PACT-Precision-Ag-Climate-Telemetry/mainboard-master/PACT_Mainboard_RevA/gerber/drill_report.txt

Drill report for mainboard-master.kicad_pcb
Created on 2026-10-30T01:10:53

Copper Layer Stackup:
    =============================================================
    L1 :  F.Cu                      front
    L2 :  B.Cu                      back

Drill file 'mainboard-master-PTH.drl' contains
    plated through holes:
    =============================================================
    T1  0.400mm  0.0157"  (92 holes))
    T2  0.750mm  0.0295"  (4 holes))
    T3  0.800mm  0.0315"  (73 holes))
    T4  0.950mm  0.0374"  (29 holes))
    T5  1.000mm  0.0394"  (24 holes))

    Total plated holes count 222

Drill file 'mainboard-master-NPTH.drl' contains
    unplated through holes:
    =============================================================
    T1  3.200mm  0.1260"  (13 holes))

    Total unplated holes count 13
