PACT-Precision-Ag-Climate-Telemetry/mainboard-master/IoTeKMITL-C1bplApo.png

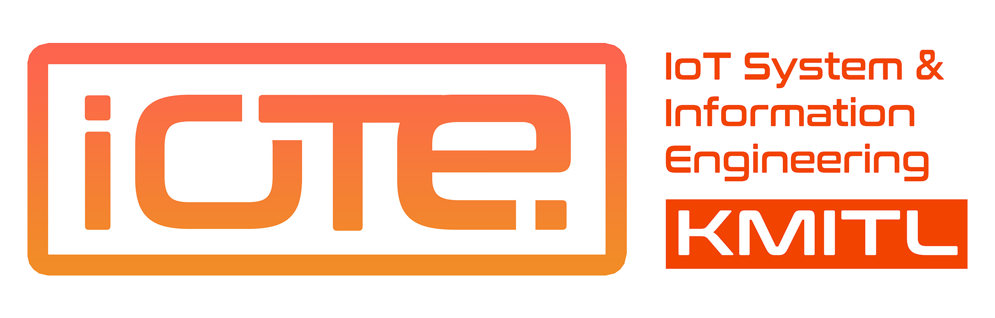
IoTeKMITL-C1bplApo.png
