PACT-Precision-Ag-Climate-Telemetry/mainboard-master/PACT_Mainboard_RevA/render_bottom.png

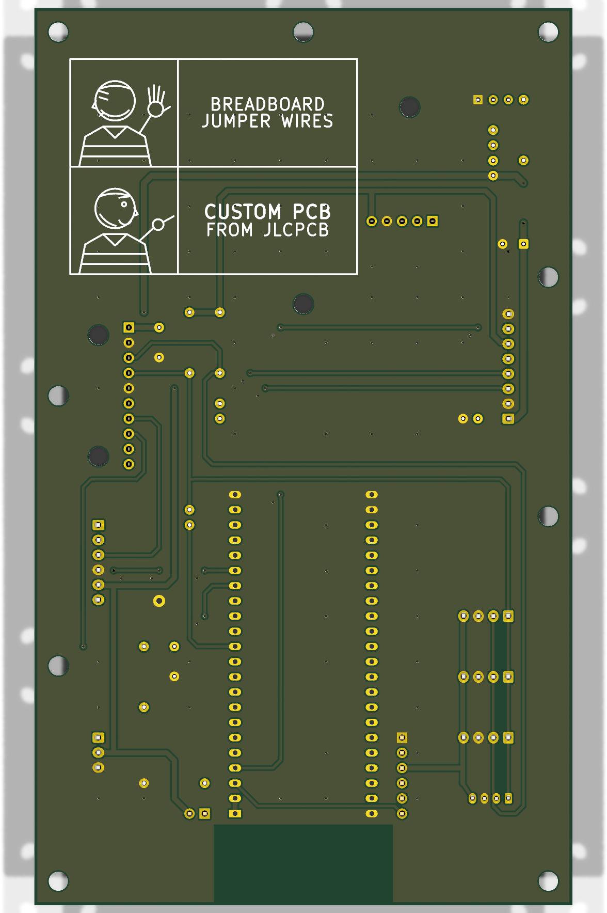
PACT_Mainboard_RevA/render_bottom.png
