PACT-Precision-Ag-Climate-Telemetry/mainboard-master/PACT_Mainboard_RevA/render_top.png

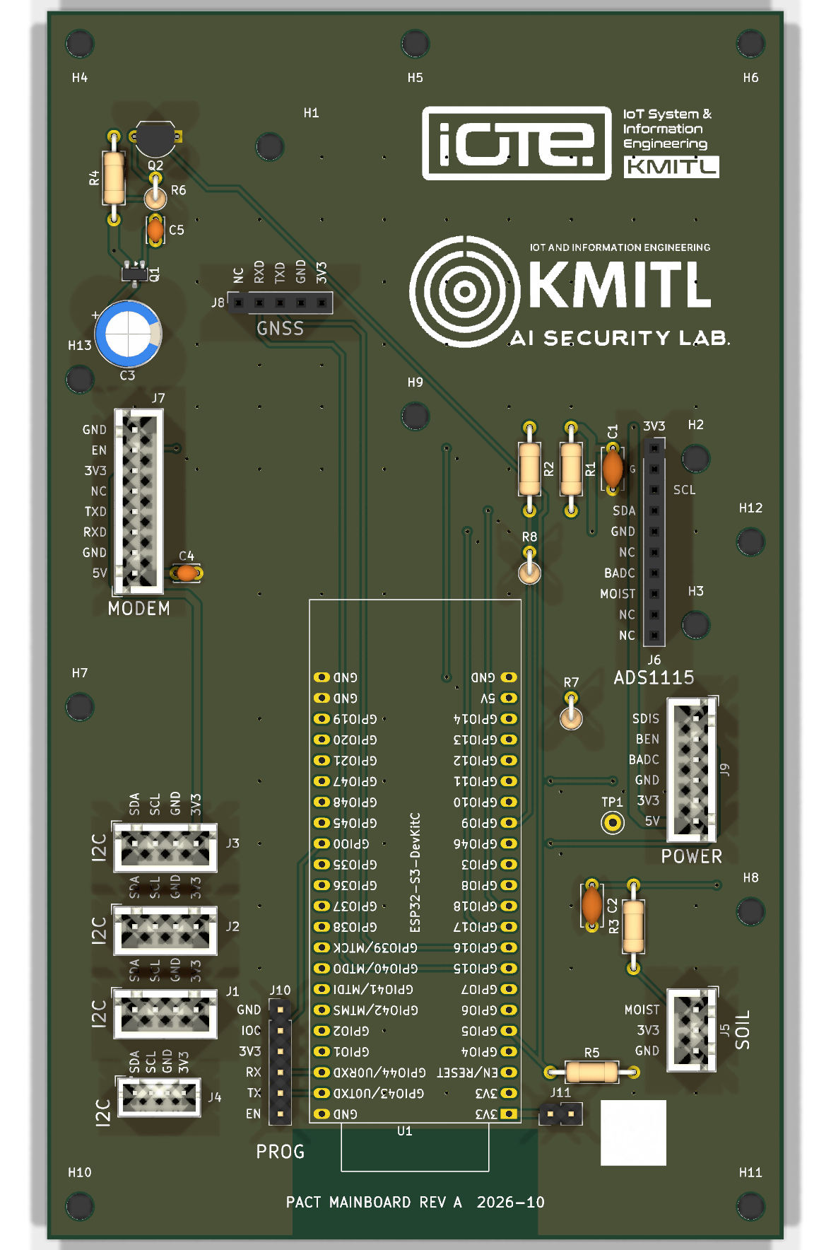
PACT_Mainboard_RevA/render_top.png
