PACT-Precision-Ag-Climate-Telemetry/mainboard-master/mainboard-master.kicad_pcb

## KiCad design mainboard-master.kicad_pcb (2026-10-29)

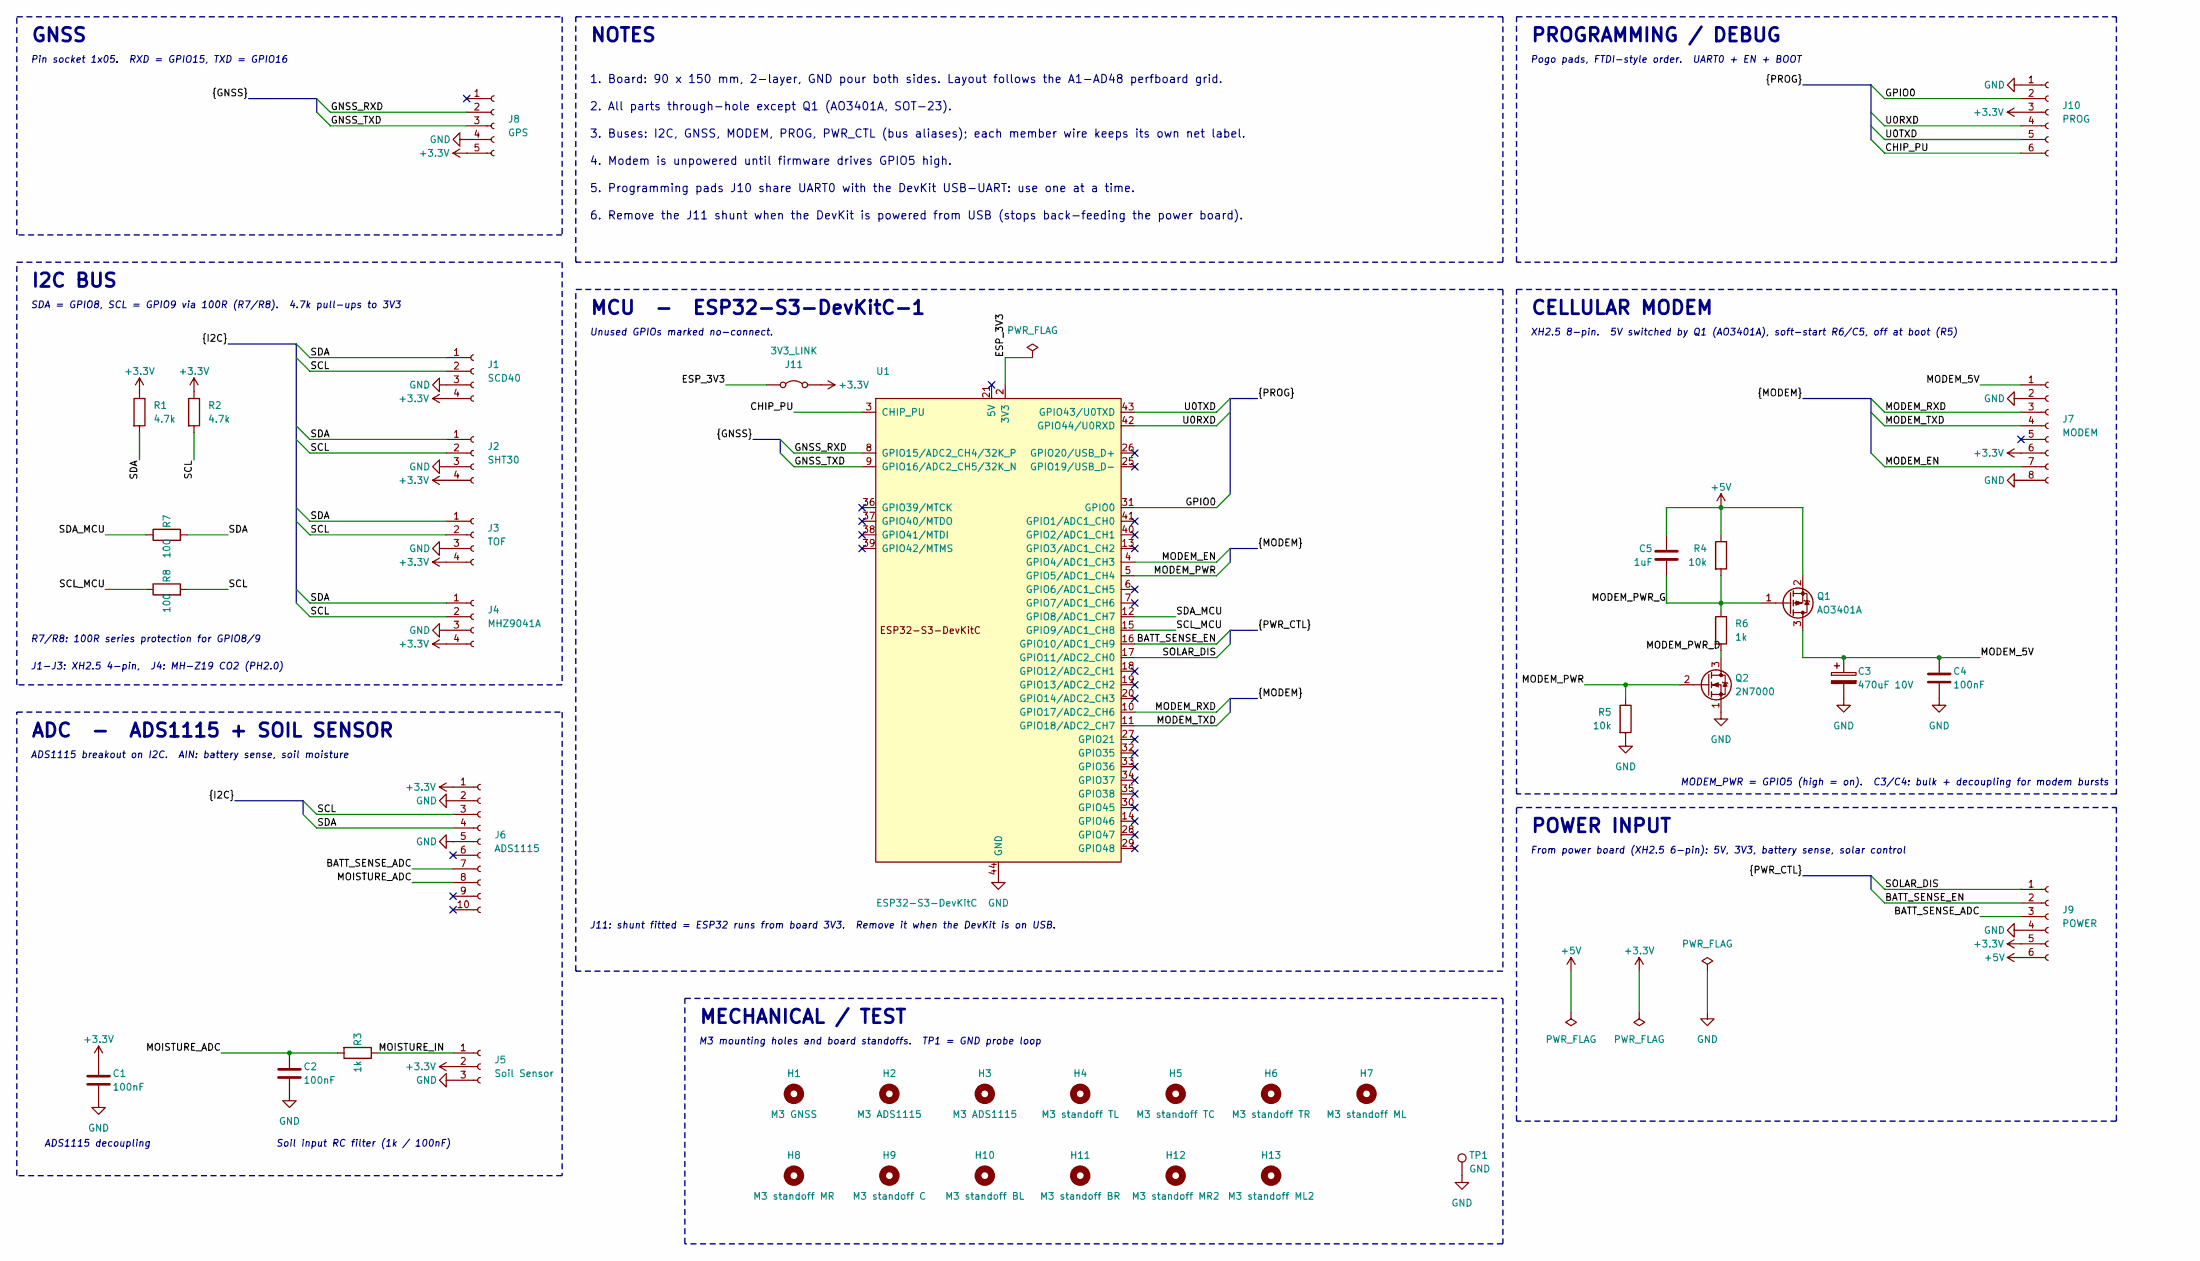
[picture p5: schematic mainboard-master.kicad_sch, PACT Mainboard]

Parts:
C1, C2: 100nF; C_Disc_D5.0mm_W2.5mm_P5.00mm
C3: 470uF 10V; CP_Radial_D8.0mm_P3.50mm
C4: 100nF; C_Disc_D3.0mm_W2.0mm_P2.50mm
C5: 1uF; C_Disc_D3.0mm_W2.0mm_P2.50mm
H1: M3 GNSS; MountingHole_3.2mm_M3
H2, H3: M3 ADS1115; MountingHole_3.2mm_M3
H4: M3 standoff TL; MountingHole_3.2mm_M3
H5: M3 standoff TC; MountingHole_3.2mm_M3
H6: M3 standoff TR; MountingHole_3.2mm_M3
H7: M3 standoff ML; MountingHole_3.2mm_M3
H8: M3 standoff MR; MountingHole_3.2mm_M3
H9: M3 standoff C; MountingHole_3.2mm_M3
H10: M3 standoff BL; MountingHole_3.2mm_M3
H11: M3 standoff BR; MountingHole_3.2mm_M3
H12: M3 standoff MR2; MountingHole_3.2mm_M3
H13: M3 standoff ML2; MountingHole_3.2mm_M3
J1: SCD40; JST_XH_B4B-XH-A_1x04_P2.50mm_Vertical
J2: SHT30; JST_XH_B4B-XH-A_1x04_P2.50mm_Vertical
J3: TOF; JST_XH_B4B-XH-A_1x04_P2.50mm_Vertical
J4: MHZ9041A; JST_PH_B4B-PH-K_1x04_P2.00mm_Vertical
J5: Soil Sensor; JST_XH_B3B-XH-A_1x03_P2.50mm_Vertical
J6: ADS1115; PinSocket_1x10_P2.54mm_Vertical
J7: MODEM; JST_XH_B8B-XH-A_1x08_P2.50mm_Vertical
J8: GPS; PinSocket_1x05_P2.54mm_Vertical
J9: POWER; JST_XH_B6B-XH-A_1x06_P2.50mm_Vertical
J10: PROG; PinHeader_1x06_P2.54mm_Vertical
J11: 3V3_LINK; PinHeader_1x02_P2.54mm_Vertical
Q1: AO3401A; SOT-23
Q2: 2N7000; TO-92_Inline_Wide
R1, R2: 4.7k; R_Axial_DIN0207_L6.3mm_D2.5mm_P10.16mm_Horizontal
R3: 1k; R_Axial_DIN0207_L6.3mm_D2.5mm_P10.16mm_Horizontal
R4, R5: 10k; R_Axial_DIN0207_L6.3mm_D2.5mm_P10.16mm_Horizontal
R6: 1k; R_Axial_DIN0207_L6.3mm_D2.5mm_P2.54mm_Vertical
R7, R8: 100; R_Axial_DIN0207_L6.3mm_D2.5mm_P2.54mm_Vertical
TP1: GND; TestPoint_Keystone_5000-5004_Miniature
U1: ESP32-S3-DevKitC

Connections:
+3.3V: C1.1, J1.4, J2.4, J3.4, J4.4, J5.2, J6.1, J7.6, J8.5, J9.5, J10.3, J11.2 (B), R1.1, R2.1
+5V: C5.1, J9.6, Q1.2 (S), R4.1
/BATT_SENSE_ADC: J6.7, J9.3
/BATT_SENSE_EN: J9.2, U1.16 (GPIO10/ADC1_CH9)
/CHIP_PU: J10.6, U1.3 (CHIP_PU)
/ESP_3V3: J11.1 (A), U1.1 (3V3), U1.2 (3V3)
/GNSS_RXD: J8.2, U1.8 (GPIO15/ADC2_CH4/32K_P)
/GNSS_TXD: J8.3, U1.9 (GPIO16/ADC2_CH5/32K_N)
/GPIO0: J10.2, U1.31 (GPIO0)
/MODEM_5V: C3.1, C4.1, J7.1, Q1.3 (D)
/MODEM_EN: J7.7, U1.4 (GPIO4/ADC1_CH3)
/MODEM_PWR: Q2.2 (G), R5.1, U1.5 (GPIO5/ADC1_CH4)
/MODEM_PWR_D: Q2.3 (D), R6.2
/MODEM_PWR_G: C5.2, Q1.1 (G), R4.2, R6.1
/MODEM_RXD: J7.3, U1.10 (GPIO17/ADC2_CH6)
/MODEM_TXD: J7.4, U1.11 (GPIO18/ADC2_CH7)
/MOISTURE_ADC: C2.1, J6.8, R3.2
/MOISTURE_IN: J5.1, R3.1
/SCL: J1.2, J2.2, J3.2, J4.2, J6.3, R2.2, R8.2
/SCL_MCU: R8.1, U1.15 (GPIO9/ADC1_CH8)
/SDA: J1.1, J2.1, J3.1, J4.1, J6.4, R1.2, R7.2
/SDA_MCU: R7.1, U1.12 (GPIO8/ADC1_CH7)
/SOLAR_DIS: J9.1, U1.17 (GPIO11/ADC2_CH0)
/U0RXD: J10.4, U1.42 (GPIO44/U0RXD)
/U0TXD: J10.5, U1.43 (GPIO43/U0TXD)
GND: C1.2, C2.2, C3.2, C4.2, J1.3, J2.3, J3.3, J4.3, J5.3, J6.2, J6.5, J7.2, J7.8, J8.4, J9.4, J10.1, Q2.1 (S), R5.2, TP1.1 (1_1), U1.22 (GND), U1.23 (GND), U1.24 (GND), U1.44 (GND)

Notes on the sheet:
MCU - ESP32-S3-DevKitC-1
4. Modem is unpowered until firmware drives GPIO5 high.
2. All parts through-hole except Q1 (AO3401A, SOT-23).
3. Buses: I2C, GNSS, MODEM, PROG, PWR_CTL (bus aliases); each member wire keeps its own net label.
5. Programming pads J10 share UART0 with the DevKit USB-UART: use one at a time.
M3 mounting holes and board standoffs. TP1 = GND probe loop
PROGRAMMING / DEBUG
J1-J3: XH2.5 4-pin, J4: MH-Z19 CO2 (PH2.0)
Soil input RC filter (1k / 100nF)
MODEM_PWR = GPIO5 (high = on). C3/C4: bulk + decoupling for modem bursts
1. Board: 90 x 150 mm, 2-layer, GND pour both sides. Layout follows the A1-AD48 perfboard grid.
CELLULAR MODEM
I2C BUS
Unused GPIOs marked no-connect.
ADS1115 decoupling
R7/R8: 100R series protection for GPIO8/9
POWER INPUT
GNSS
J11: shunt fitted = ESP32 runs from board 3V3. Remove it when the DevKit is on USB.
ADC - ADS1115 + SOIL SENSOR
MECHANICAL / TEST
Pin socket 1x05. RXD = GPIO15, TXD = GPIO16
SDA = GPIO8, SCL = GPIO9 via 100R (R7/R8). 4.7k pull-ups to 3V3
6. Remove the J11 shunt when the DevKit is powered from USB (stops back-feeding the power board).
NOTES
XH2.5 8-pin. 5V switched by Q1 (AO3401A), soft-start R6/C5, off at boot (R5)
ADS1115 breakout on I2C. AIN: battery sense, soil moisture
From power board (XH2.5 6-pin): 5V, 3V3, battery sense, solar control
Pogo pads, FTDI-style order. UART0 + EN + BOOT

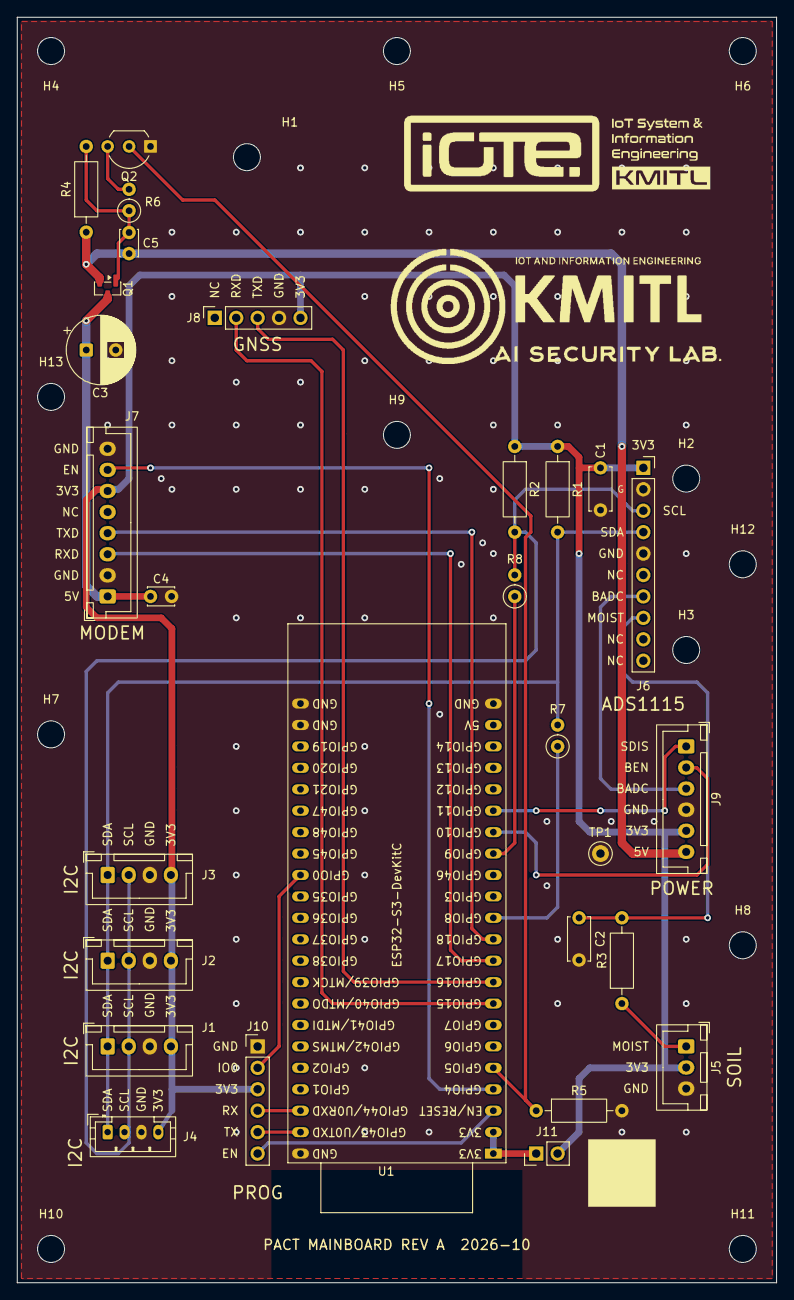
[picture p6: board mainboard-master.kicad_pcb from above]

Board: 2 copper layers, 90.0 x 150.0 mm, 41 parts (0 on the bottom side), 26 nets.
